migueldufloth/access/firmware/Access/cert_isrg_root_x1.h

#pragma once

// Certificado raiz da cadeia TLS usada pelo broker (Let's Encrypt).
// Emissor: ISRG Root X1 (Internet Security Research Group)
// Validade: 04/06/2015 a 04/06/2035
// Fonte: https://letsencrypt.org/certs/isrgrootx1.pem
// É público, não é segredo — pode ser versionado normalmente.

const char* ISRG_ROOT_X1_PEM = R"EOF(
-----BEGIN CERTIFICATE-----
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
-----END CERTIFICATE-----
)EOF";
