migueldufloth/access/(commit log)

2026-08-24 Update README.md
    - Adicionada especificação detalhada de hardware (ESP32, PIR HC-SR501, Pushbutton, Buzzer, LED e periféricos)
    - Atualizada arquitetura inicial com fluxos de telemetria, controle remoto e alerta local
    - Inserida imagem do protótipo do circuito no Wokwi
2026-08-25 Alinha README a estrutura minima do guia da N1 (backlog, duvidas, instrucoes de execucao) e adiciona tarefa de validacao de leitura
2026-09-08 docs: alinha README ao firmware atual (sensor, pinagem, OLED, status)
    O README ainda descrevia o projeto como planejado (sensor PIR, MQTT ja
    publicando, pinagem antiga do buzzer/LED), nao como o sketch em
    firmware/Access/Access.ino realmente implementa. Corrige pinagem,
    bibliotecas e arquitetura para refletir o codigo, marca a secao MQTT
    como arquitetura-alvo ainda nao implementada, documenta o secrets.h
    esperado e atualiza o backlog (Wi-Fi e testes feitos, MQTT pendente).
2026-09-08 docs: corrige integrantes, identificacao da equipe e versiona o prototipo
    Nomes da secao Integrantes estavam abreviados; troca pela lista oficial
    da turma. Titulo e Familia Tematica contradiziam a designacao oficial
    "05 - Controle de Acesso" ao tratar N1 e N2/N3 como temas diferentes;
    reescreve como estagios de escopo dentro do mesmo tema. Protótipo do
    Circuito agora separa a concepcao inicial (imagem e link do Wokwi
    originais, preservados) da implementacao atual, que ainda nao tem
    diagrama proprio.
2026-09-08 docs: registra evolucao v1->v2 e reescreve backlog por versao
    A nota sobre o sensor magnetico e o bloco do prototipo tratavam a
    mudanca como correcao de erro; reescreve como evolucao de protototipo,
    registrando as duas motivacoes (kit adquirido pela equipe e adequacao
    ao problema) e que a Versao 1 foi montada e testada com sucesso.
    Backlog Inicial vira Backlog, com coluna Versao (v1/v2) para que
    nenhuma tarefa concluida na v1 seja lida como funcionalidade presente
    no firmware atual; tarefas novas cobrem o que falta para a N1 (MQTT,
    LED, botao, diagrama v2, documentacao, ensaio), com responsaveis e
    prazos dados pela equipe. A remissao ao doc da Aula 04 agora deixa
    claro que ele registra o es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
2026-09-09 chore: adiciona secrets.example.h, certificado raiz e dependências
    Prepara a base para a migração para MQTT sobre WSS (v3): modelo de
    credenciais sem valores reais, certificado raiz ISRG Root X1 público
    para verificação TLS, e documentação da dependência ArduinoJson.
2026-09-09 refactor: extrai configuração para config.h e adiciona estado do alarme
    Centraliza pinos, intervalos e nomes de tópicos MQTT em config.h, fonte
    única de verdade para evitar divergência entre firmware e documentação.
    Introduz sistemaArmado, alarmeDisparado, brokerConectado e
    ultimoContatoBroker, que passam a governar o disparo do alarme a partir
    da Etapa 8 — a leitura direta do sensor no loop() ainda decide por ora.
    [Access.ino, config.h]
2026-09-15 feat: versiona configuração do broker MQTT (mosquitto + nginx)
    Adiciona broker/ com os arquivos de deploy do Mosquitto (listeners,
    ACL) e do vhost nginx que expõe o WebSocket via accessgrupo5.duckdns.org,
    implementando a arquitetura MQTT já descrita no README. Senhas e
    certificados TLS ficam fora do repositório, só no servidor.
2026-09-15 docs: adiciona roteiro técnico de MQTT para o Lucas
    Traduz as Etapas 3 e 4 da migração (sincronização de hora, conexão
    wss com Last Will, publicação de telemetria) num guia prático para
    ele aplicar no próprio firmware, usando o que já está em config.h,
    secrets.example.h e cert_isrg_root_x1.h.
2026-09-15 docs: documenta conectividade MQTT externa do ESP32 via WSS
    A porta 1883 do broker só é alcançável em LAN/Tailscale, de propósito
    (evitar MQTT sem TLS exposto à internet). Como o ESP32 do projeto fica
    em rede diferente da do broker, PubSubClient puro não serve: registra
    que a conexão precisa ser MQTT sobre WebSocket com TLS
    (wss://accessgrupo5.duckdns.org/mqtt), via esp_mqtt_client do ESP-IDF,
    e ajusta backlog e instruções de execução para refletir isso.
2026-09-15 feat: implementa painel de telemetria em broker/www/index.html
    Arquivo único, sem build, usa mqtt.js via CDN sobre o mesmo endpoint
    wss do ESP32. Assina sensor/presenca e status/#, publica os quatro
    comandos, e isola a regra de disparo automático (porta aberta + armado)
    numa função própria para facilitar alterar ao vivo na validação.
    Credenciais do access_web ficam em config.js, fora do git, com
    config.example.js versionado como modelo. Visual propositalmente cru:
    monoespaçado, sem framework de CSS, sem sombra/gradiente/ícone.
2026-09-15 feat: melhora visibilidade e usabilidade do painel de telemetria
    Faixa de alarme em largura total quando disparado=true, em vez de só
    uma célula colorida na tabela. Timestamp de última telemetria que
    envelhece a cada segundo e marca como obsoleta acima de 30s (mesmo
    limiar do modo degradado do firmware), para distinguir "sem novidade"
    de "parou de chegar". Log agora marca [auto] vs [manual] em cada
    comando publicado, para diferenciar a regra automática de disparo de
    um clique — útil na validação ao vivo. Mesmo estilo cru de antes, sem
    dependência nova.
2026-09-15 feat: alarme passa a ser acionado por comando remoto e adiciona modo degradado
    O loop() decide o buzzer por alarmeDisparado (vindo do MQTT), não mais
    pela leitura direta do sensor. Remove o delay(30) do fim do loop();
    o OLED agora redesenha por cadência própria via millis()
    (INTERVALO_ATUALIZACAO_OLED), sem bloquear o resto do laço.
    Adiciona modo degradado: sem contato com o broker por mais de
    TIMEOUT_MODO_DEGRADADO (30s), o firmware volta a decidir o alarme
    localmente pelo sensor, como na v2, e sinaliza isso no log serial e na
    barra de status do OLED ([LOCAL]). É a única exceção à regra de que só
    o tratamento de comando escreve em alarmeDisparado — com o broker de
    volta, a deci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
    [Access.ino]
2026-09-15 docs: atualiza README para a versão 3 com MQTT
    Reescreve arquitetura, contrato de tópicos, status de implementação,
    instruções de execução, backlog e histórico de versões para refletir
    o firmware e o broker reais, não mais a arquitetura-alvo. Adiciona
    seções de Modo Degradado, Segurança e Enquadramento IoT (checklist do
    edital mapeado para onde cada item é atendido no código).
    Status real, sem inflar: reorganização do firmware em múltiplos
    arquivos e os docs dedicados de infraestrutura/contingência do broker
    continuam como pendência, marcados como tal.
2026-09-16 fix: corrige buzzer preso ao dobrar debounce do disparo automático
    avaliarDisparoAutomatico() reavaliava a mesma condição a cada
    telemetria (a cada ~5s), então enquanto a porta seguisse aberta e o
    sistema armado o painel republicava "disparar" sozinho, sobrescrevendo
    qualquer "silenciar" manual segundos depois. Agora só dispara na
    transição para a condição, e reseta quando ela deixa de valer (porta
    fecha ou sistema desarma), voltando a permitir novo disparo automático
    na próxima abertura de verdade.
2026-09-17 feat: adiciona leitura validada do sensor com debounce por tempo
2026-10-20 docs: adiciona proposta de upgrade CP12 (seções 1 a 4) e direção do upgrade no README
2026-10-28 docs: conclui o CP12 com seções 5 a 9, contrato v1 e projeto de hardware
    - adiciona a proposta completa (PDF e fonte em Markdown) com as seções 5 a 9 e os anexos
    - congela o contrato MQTT como v1 em CONTRATOS.md
    - adiciona esquemas elétricos, mapa de pinos, BOM e verificação elétrica em hardware/
    - adiciona fluxograma do firmware e esboço das telas
    - atualiza as pendências da conferência R1 a R18 e os READMEs
    - remove metadados embutidos dos SVGs antigos
2026-10-28 docs: preenche a seção 9 do CP12 e finaliza o PDF completo
    - registra o hash do commit, os usuários do GitHub dos integrantes e o link do repositório
    - remove marcações de rascunho e o checklist de envio do documento
    - regera o PDF completo
